Barcarola137/TangMega60K_FPGA_Synthesizer/README.md

# TangMega60K_FPGA_Synthesizer
高云杯选题二：纯FPGA实时多音色合成电子乐器
