Barcarola137/TangMega60K_FPGA_Synthesizer/编译指南.pdf

您好，首次打开工程请按以下两步操作：

1．点击左侧 Hierarchy,右键左上方 top，选择 Set As Top Module。

2．顶部菜单 Project ->Configuration -> Place &Route -> 点击 Dual-PurposePin 勾选 Use CPU as regular IO 和 Use SSPI as regular IO，点击 OK。 3．点击 Synthesize 和 Place & Route 即可成功复 现。
