Barcarola137/TangMega60K_FPGA_Synthesizer/src/gowin_pll/gowin_pll_mod.v

// 模块名称: IP file (PLL Primitive)
// 项目名称: 高云杯 选题二 - 基于FPGA的实时多音色合成电子乐器引擎
// 文件描述：
// 本文件为高云 GW5AT-60 芯片底层的 PLL 硬件原语 (PLLA) 实例化代码。
// 负责将板载 50MHz 晶振时钟转换为音频合成引擎核心所需的时钟信号。
// 该模块由 Gowin IP Core Generator 自动生成，参数严格匹配芯片物理特性。

module Gowin_PLL_MOD (lock, clkout0, mdrdo, clkin, reset, mdclk, mdopc, mdainc, mdwdi);

output lock;
output clkout0;
output [7:0] mdrdo;
input clkin;
input reset;
input mdclk;
input [1:0] mdopc;
input mdainc;
input [7:0] mdwdi;

wire clkout1;
wire clkout2;
wire clkout3;
wire clkout4;
wire clkout5;
wire clkout6;
wire clkfbout;
wire gw_gnd;

assign gw_gnd = 1'b0;

// 1. 锁相环底层硬件原语例化 (PLLA)
// 说明：直接调用 FPGA 内部硬核 PLL，提供极低的时钟抖动 (Jitter) 和相位偏移，
//       保证高保真音频 DDS 运算与 I2S 协议时序的绝对稳定。
PLLA PLLA_inst (
    .LOCK(lock),               // 锁定信号输出 (高电平表示时钟稳定)
    .CLKOUT0(clkout0),         // 主时钟输出 (供音频合成域使用)
    .CLKOUT1(clkout1),
    .CLKOUT2(clkout2),
    .CLKOUT3(clkout3),
    .CLKOUT4(clkout4),
    .CLKOUT5(clkout5),
    .CLKOUT6(clkout6),
    .CLKFBOUT(clkfbout),
    .MDRDO(mdrdo),
    .CLKIN(clkin),             // 输入时钟 (50MHz)
    .CLKFB(gw_gnd),            // 内部反馈 (已设为 INTERNAL)
    .RESET(reset),
    .PLLPWD(gw_gnd),           // 低功耗模式关闭
    .RESET_I(gw_gnd),
    .RESET_O(gw_gnd),
    .PSSEL({gw_gnd,gw_gnd,gw_gnd}), // 动态相移关闭
    .PSDIR(gw_gnd),
    .PSPULSE(gw_gnd),
    .SSCPOL(gw_gnd),           // 扩频时钟关闭 (音频不需要，需要纯净时钟)
    .SSCON(gw_gnd),
    .SSCMDSEL({gw_gnd,gw_gnd,gw_gnd,gw_gnd,gw_gnd,gw_gnd,gw_gnd}),
    .SSCMDSEL_FRAC({gw_gnd,gw_gnd,gw_gnd}),
    .MDCLK(mdclk),             // 动态配置接口 (用于复位初始化)
    .MDOPC(mdopc),
    .MDAINC(mdainc),
    .MDWDI(mdwdi)
);

// 2. 硬件参数配置详解 (Defparam)
// 高云的 PLL 结构通过 IDIV(输入分频)、FBDIV(反馈倍频)、ODIV(输出分频) 
// 配合 VCO (压控振荡器) 产生目标时钟。
// 
// 我们的目标时钟是 12.288MHz (I2S 标准采样率 48kHz * 256)。
// 理想公式: 50MHz * FBDIV / (IDIV * ODIV) = 12.288MHz
// 但受限于物理硬件的整数分频步进，软件计算出最逼近的配置如下：
//    基础系数配置后，VCO 频率锁定在约 712MHz
//    最后经过 ODIV0 分频，输出实际物理频率约为 12.281MHz。
// 
// 误差分析：12.288MHz 与 12.281MHz 误差仅为 0.057%。这远低于 PT8211 DAC 
// 芯片的时钟容差范围。这一微小偏差不会对音高准度产生任何可闻影响，是
// 兼顾系统时钟源与音乐标准频率的最优物理折中方案。
defparam PLLA_inst.FCLKIN = "50";       // 输入时钟 50MHz
defparam PLLA_inst.IDIV_SEL = 1;        // 输入分频系数
defparam PLLA_inst.FBDIV_SEL = 1;       // 反馈分频系数
defparam PLLA_inst.ODIV0_SEL = 57;      // 输出 0 的分频系数 (决定最终音频时钟)
defparam PLLA_inst.ODIV1_SEL = 8;       // 其他未使用通道的默认分频
defparam PLLA_inst.ODIV2_SEL = 8;
defparam PLLA_inst.ODIV3_SEL = 8;
defparam PLLA_inst.ODIV4_SEL = 8;
defparam PLLA_inst.ODIV5_SEL = 8;
defparam PLLA_inst.ODIV6_SEL = 8;
defparam PLLA_inst.MDIV_SEL = 14;       // VCO 倍频系数 (核心参数)
defparam PLLA_inst.MDIV_FRAC_SEL = 0;   // 小数分频配置 (未使用)
defparam PLLA_inst.ODIV0_FRAC_SEL = 0;

// 使能控制：仅开启 CLKOUT0，关闭其余 6 个通道，极致节省芯片功耗
defparam PLLA_inst.CLKOUT0_EN = "TRUE";
defparam PLLA_inst.CLKOUT1_EN = "FALSE";
defparam PLLA_inst.CLKOUT2_EN = "FALSE";
defparam PLLA_inst.CLKOUT3_EN = "FALSE";
defparam PLLA_inst.CLKOUT4_EN = "FALSE";
defparam PLLA_inst.CLKOUT5_EN = "FALSE";
defparam PLLA_inst.CLKOUT6_EN = "FALSE";

defparam PLLA_inst.CLKFB_SEL = "INTERNAL"; // 使用内部反馈，减少外部走线干扰，降低抖动

// 以下为相位动态调整、动态相移等高级特性的开关，本项目不需要，保持默认关闭
defparam PLLA_inst.CLKOUT0_DT_DIR = 1'b1;
defparam PLLA_inst.CLKOUT1_DT_DIR = 1'b1;
defparam PLLA_inst.CLKOUT2_DT_DIR = 1'b1;
defparam PLLA_inst.CLKOUT3_DT_DIR = 1'b1;
defparam PLLA_inst.CLKOUT0_DT_STEP = 0;
defparam PLLA_inst.CLKOUT1_DT_STEP = 0;
defparam PLLA_inst.CLKOUT2_DT_STEP = 0;
defparam PLLA_inst.CLKOUT3_DT_STEP = 0;
defparam PLLA_inst.CLK0_IN_SEL = 1'b0;
defparam PLLA_inst.CLK0_OUT_SEL = 1'b0;
defparam PLLA_inst.CLK1_IN_SEL = 1'b0;
defparam PLLA_inst.CLK1_OUT_SEL = 1'b0;
defparam PLLA_inst.CLK2_IN_SEL = 1'b0;
defparam PLLA_inst.CLK2_OUT_SEL = 1'b0;
defparam PLLA_inst.CLK3_IN_SEL = 1'b0;
defparam PLLA_inst.CLK3_OUT_SEL = 1'b0;
defparam PLLA_inst.CLK4_IN_SEL = 2'b00;
defparam PLLA_inst.CLK4_OUT_SEL = 1'b0;
defparam PLLA_inst.CLK5_IN_SEL = 1'b0;
defparam PLLA_inst.CLK5_OUT_SEL = 1'b0;
defparam PLLA_inst.CLK6_IN_SEL = 1'b0;
defparam PLLA_inst.CLK6_OUT_SEL = 1'b0;
defparam PLLA_inst.DYN_DPA_EN = "FALSE";
defparam PLLA_inst.CLKOUT0_PE_COARSE = 0;
defparam PLLA_inst.CLKOUT0_PE_FINE = 0;
defparam PLLA_inst.CLKOUT1_PE_COARSE = 0;
defparam PLLA_inst.CLKOUT1_PE_FINE = 0;
defparam PLLA_inst.CLKOUT2_PE_COARSE = 0;
defparam PLLA_inst.CLKOUT2_PE_FINE = 0;
defparam PLLA_inst.CLKOUT3_PE_COARSE = 0;
defparam PLLA_inst.CLKOUT3_PE_FINE = 0;
defparam PLLA_inst.CLKOUT4_PE_COARSE = 0;
defparam PLLA_inst.CLKOUT4_PE_FINE = 0;
defparam PLLA_inst.CLKOUT5_PE_COARSE = 0;
defparam PLLA_inst.CLKOUT5_PE_FINE = 0;
defparam PLLA_inst.CLKOUT6_PE_COARSE = 0;
defparam PLLA_inst.CLKOUT6_PE_FINE = 0;
defparam PLLA_inst.DYN_PE0_SEL = "FALSE";
defparam PLLA_inst.DYN_PE1_SEL = "FALSE";
defparam PLLA_inst.DYN_PE2_SEL = "FALSE";
defparam PLLA_inst.DYN_PE3_SEL = "FALSE";
defparam PLLA_inst.DYN_PE4_SEL = "FALSE";
defparam PLLA_inst.DYN_PE5_SEL = "FALSE";
defparam PLLA_inst.DYN_PE6_SEL = "FALSE";
defparam PLLA_inst.DE0_EN = "FALSE";
defparam PLLA_inst.DE1_EN = "FALSE";
defparam PLLA_inst.DE2_EN = "FALSE";
defparam PLLA_inst.DE3_EN = "FALSE";
defparam PLLA_inst.DE4_EN = "FALSE";
defparam PLLA_inst.DE5_EN = "FALSE";
defparam PLLA_inst.DE6_EN = "FALSE";
defparam PLLA_inst.RESET_I_EN = "FALSE";
defparam PLLA_inst.RESET_O_EN = "FALSE";
defparam PLLA_inst.ICP_SEL = 6'bXXXXXX;
defparam PLLA_inst.LPF_RES = 3'bXXX;
defparam PLLA_inst.LPF_CAP = 2'b00;
defparam PLLA_inst.SSC_EN = "FALSE";    // 关闭展频，保证音频纯净度

endmodule //Gowin_PLL_MOD
